LZ1PPL/Si4735/README.md

# Reciver based on Si4735 and Si5351
The Si5351 is used as a local oscilator to create IF frequency of 10.7MHz. 
The demodulation of the signals and filters is achived in the Si4735.
