LZ1PPL/Si4735/Hardware/si4735v2.3.1.pdf

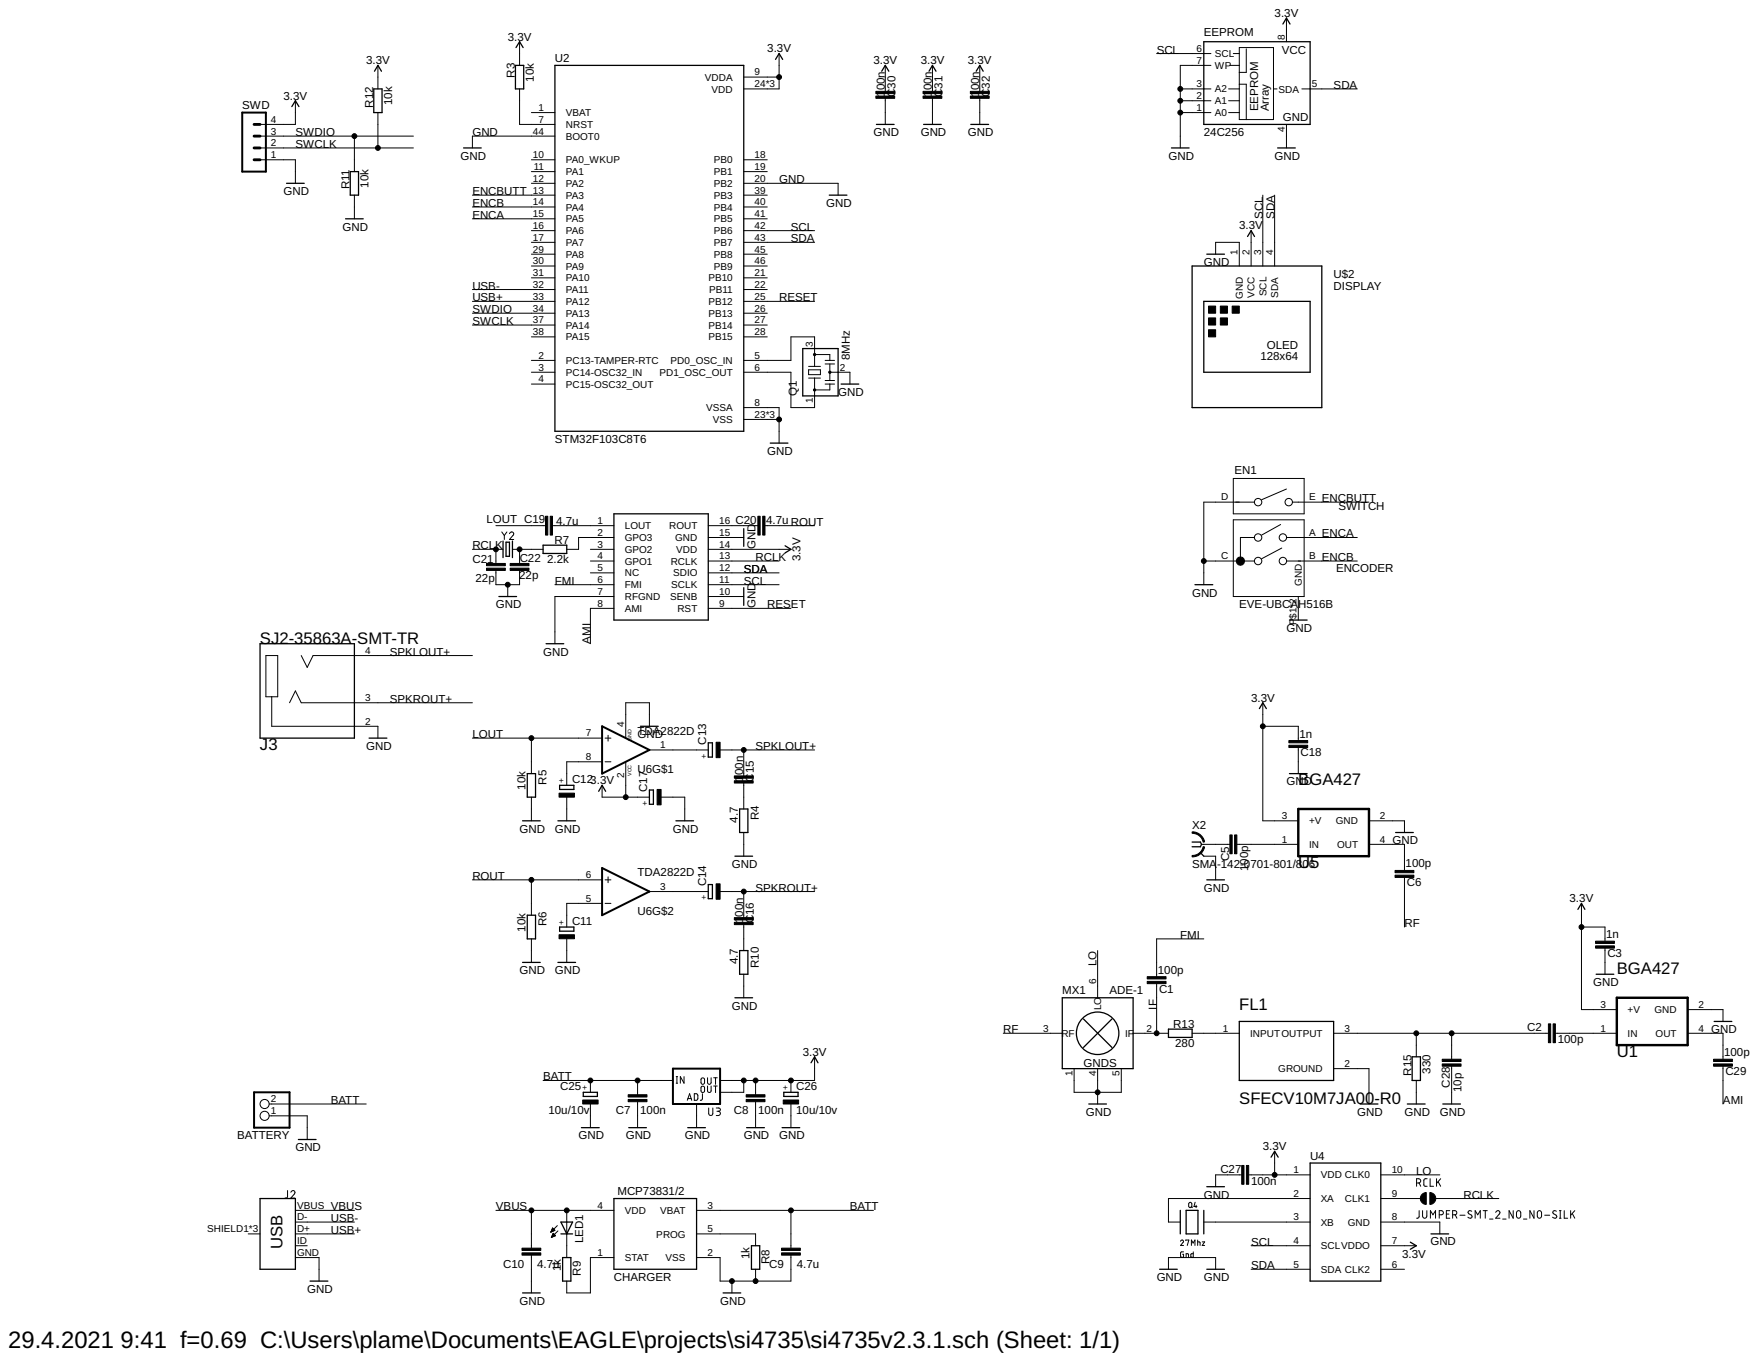
[picture p1: page 1]

29.4.2021 9:41 f=0.69 C:\Users\plame\Documents\EAGLE\projects\si4735\si4735v2.3.1.sch (Sheet: 1/1)
