LZ1PPL/Si4735/Hardware/si4735v2.3.1_b.pdf

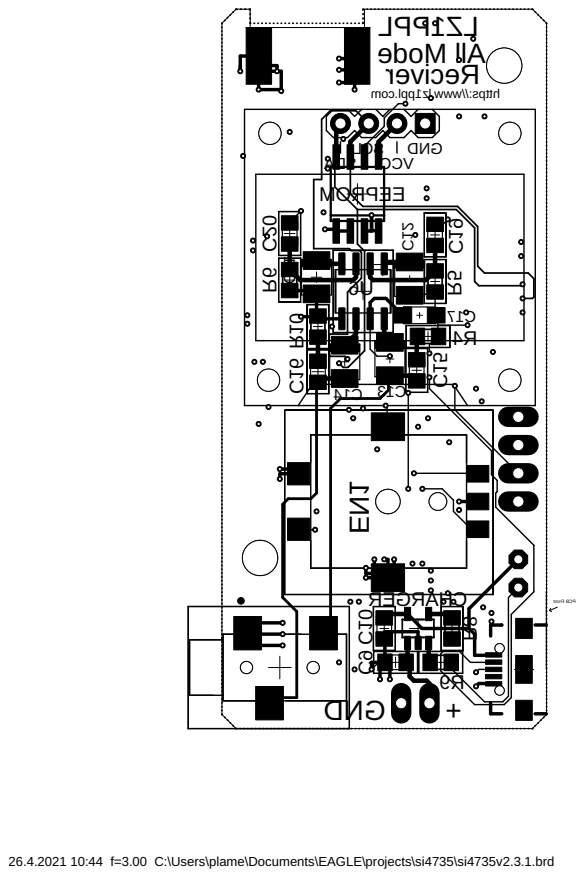
[picture p2: page 1]

26.4.2021 10:44 f=3.00 C:\Users\plame\Documents\EAGLE\projects\si4735\si4735v2.3.1.brd
