LZ1PPL/Si4735/Hardware/si4735v2.4.brd

## EAGLE design Hardware/si4735v2.4.brd (2021-06-22)

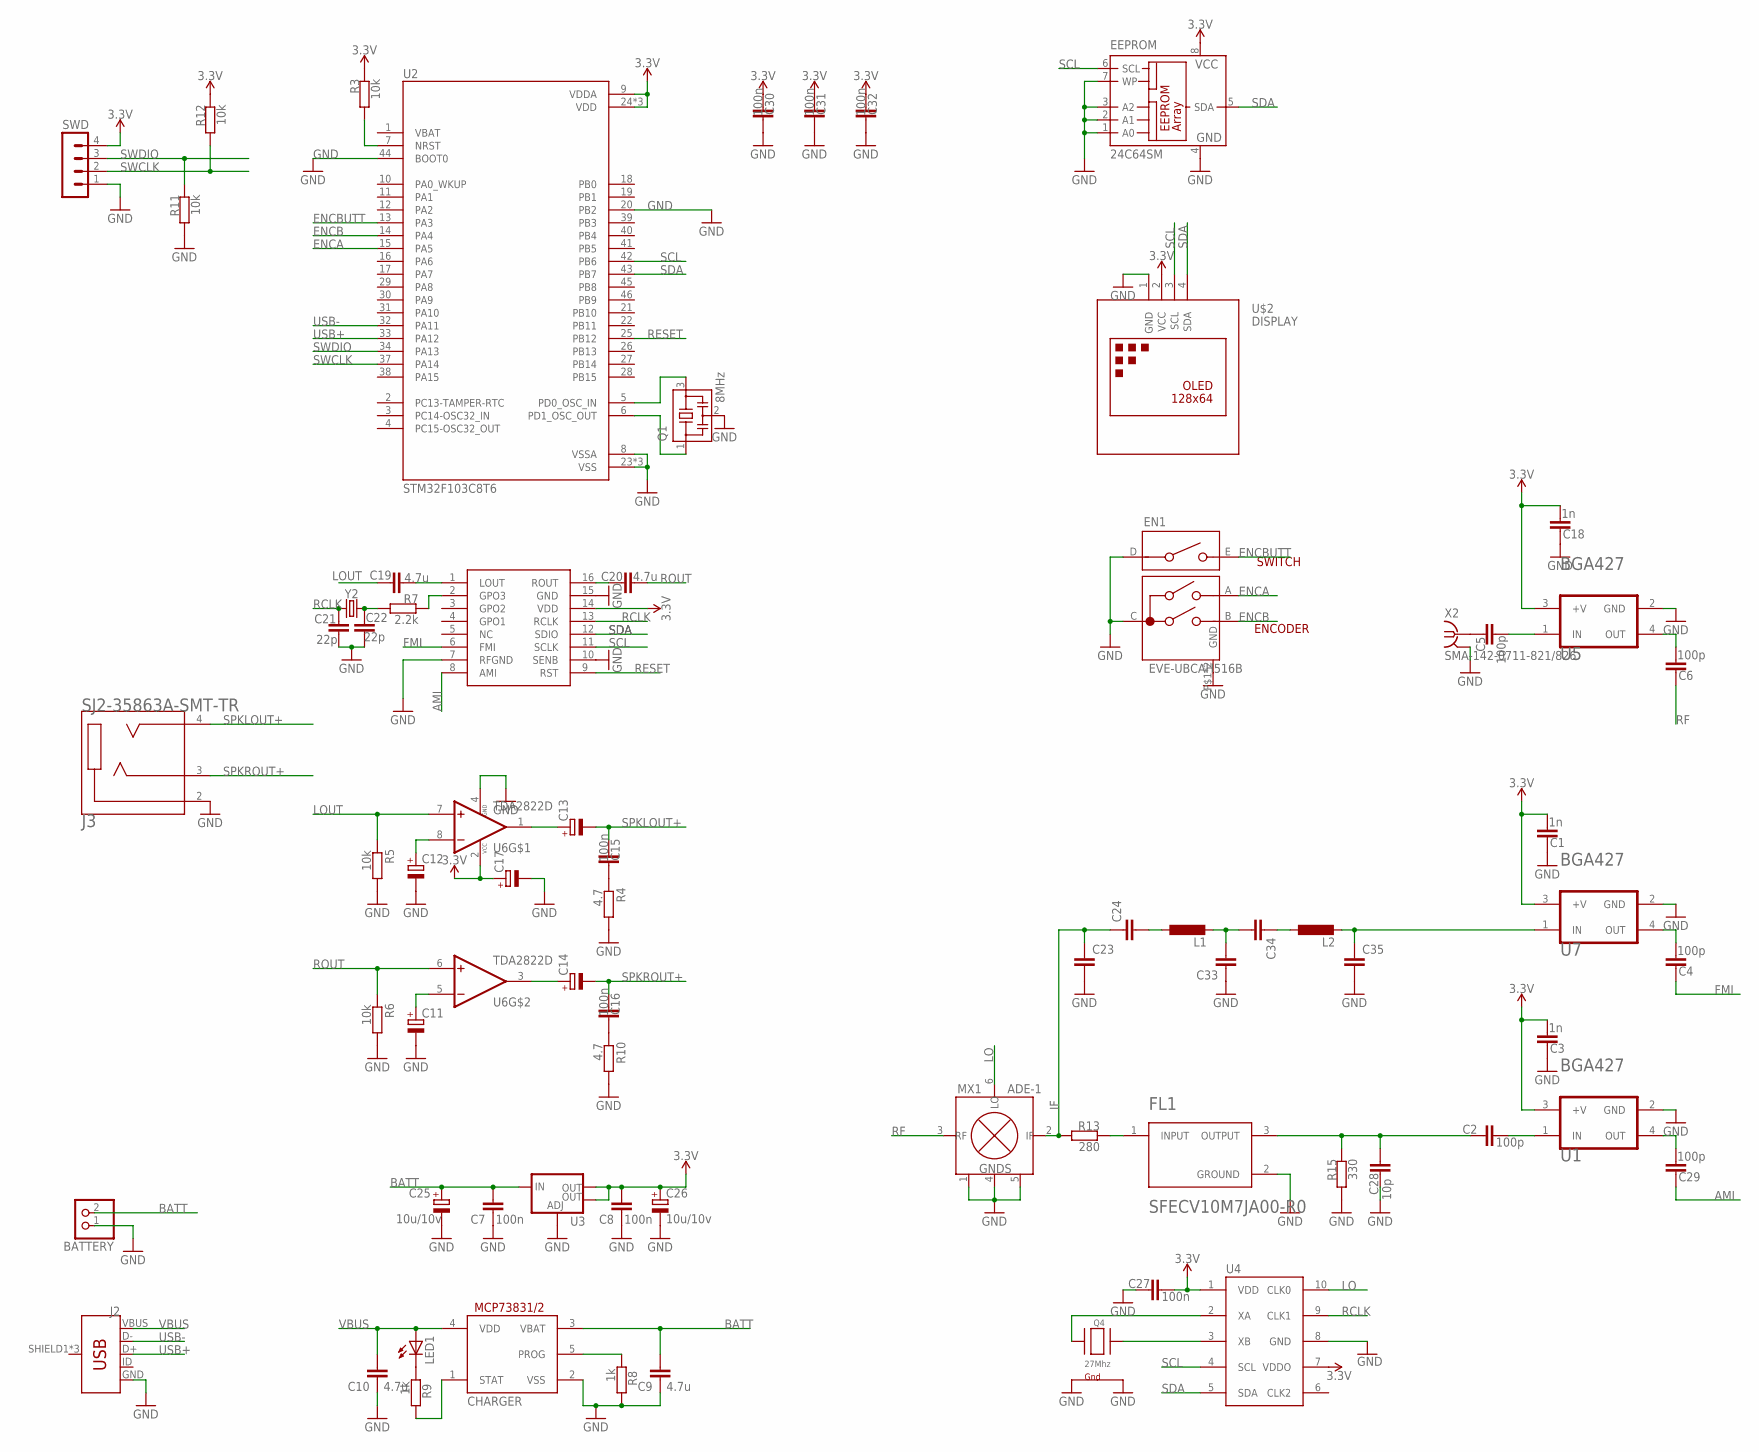
[picture p4: schematic si4735v2.4.sch]

Parts:
BATTERY: PINHD-1X2; 1X02
C1, C3, C18: 1n; C0805
C2, C4, C5, C6, C29: 100p; C0805
C7, C8, C15, C16, C27, C30, C31, C32: 100n; C0805
C9, C10, C19, C20: 4.7u; C0805
C11, C12, C13, C14: CPOL-EUSMCB; SMC_B
C17: CPOL-EUSMCA; SMC_A
C21, C22: 22p; C0805
C23, C24, C33, C34, C35: C-EUC0603; C0603
C25, C26: 10u/10v; A/3216-18W
C28: 10p; C0805
CHARGER: MCP73831/OT; SOT23-5L
EEPROM: 24C64SM; SO-08M
EN1: EVE-UBCAH516B
FL1: MURATA_ELECTRONICS_NORTH_AMERICA_SFECV10M7JA00-R0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; MURATA_ELECTRONICS_NORTH_AMERICA_SFECV10M7JA00-R0_0
J2: USB_MICRO-BREDUCED_PASTE; USB-B-MICRO-SMD_RED_PASTE
J3: SJ2-35863A-SMT-TR; CUI_SJ2-35863A-SMT-TR
L1, L2: L-EUL0603; L0603
LED1: LED3MM
MX1: ADE-1; CD636
Q1: 8MHz; CSTCR6M
Q4: 27Mhz; NX3225
R3, R5, R6, R11, R12: 10k; R0805
R4, R10: 4.7; R0805
R7: 2.2k; R0805
R8, R9: 1k; R0805
R13: 280; R0805
R15: 330; R0805
SI4732-A10: SI4732; SOIC127P600X175-16N
SWD: MA04-1
U1, U5, U7: INFINEON_BGA427INFINEON_BGA427_0_0; INFINEON_BGA427_0
U2: STM32F103C8T6; QFP50P900X900X160-48N
U3: V_REG_LM1117SOT223; SOT223
U4: SI5351A_CLOCK_GEN; MSOP-10
U6: TDA2822D; SOIC127P600X175-8N
U$2: DISPLAY; DISPLAY-OLED-128X64-I2C
X2: SMA-142-0711-821/826; J502-ND-142-0711-821/826
Y2: CRYSTALSMD-3.2X1.5; CRYSTAL-SMD-3.2X1.5MM

Connections:
3.3V: C1.1, C3.1, C8.2, C17.+, C18.1, C26.+, C27.1, C30.2, C31.2, C32.2, EEPROM.8 (VCC), R3.1, R12.1, SI4732-A10.14 (VDD), SWD.4, U1.3 (+V), U2.9 (VDDA), U2.24 (VDD), U2.36 (VDD), U2.48 (VDD), U3.2 (OUT), U3.4 (OUT), U4.1 (VDD), U4.7 (VDDO), U5.3 (+V), U6.2 (VCC), U7.3 (+V), U$2.2 (VCC)
AMI: C29.2, SI4732-A10.8 (AMI)
BATT: BATTERY.2, C7.2, C9.2, C25.+, CHARGER.3 (VBAT), U3.3 (IN)
ENCA: EN1.A, U2.15 (PA5)
ENCB: EN1.B, U2.14 (PA4)
ENCBUTT: EN1.E, U2.13 (PA3)
FILTER: C2.2, C28.1, FL1.3 (OUTPUT), R15.1
FMI: C4.2, SI4732-A10.6 (FMI)
GND: BATTERY.1, C1.2, C3.2, C7.1, C8.1, C9.1, C10.1, C11.-, C12.-, C17.-, C18.2, C21.1, C22.1, C23.2, C25.-, C26.-, C27.2, C28.2, C30.1, C31.1, C32.1, C33.1, C35.2, CHARGER.2 (VSS), EEPROM.1 (A0), EEPROM.2 (A1), EEPROM.3 (A2), EEPROM.4 (GND), EEPROM.7 (WP), EN1.C, EN1.D, EN1.P$1 (GND), EN1.P$2 (GND), FL1.2 (GROUND), J2.GND, J3.2 (SLEEVE), MX1.1 (GND), MX1.4 (GND), MX1.5 (GND), Q1.2, Q4.2 (G2), Q4.4 (G1), R4.2, R5.2, R6.2, R8.2, R10.2, R11.2, R15.2, SI4732-A10.7 (RFGND), SI4732-A10.10 (SENB), SI4732-A10.15 (GND), SWD.1, U1.2 (GND), U2.8 (VSSA), U2.20 (PB2), U2.23 (VSS), U2.35 (VSS), U2.44 (BOOT0), U2.47 (VSS), U3.1 (ADJ), U4.8 (GND), U5.2 (GND), U6.4 (GND), U7.2 (GND), U$2.1 (GND), X2.G@1 (2), X2.G@2 (2), X2.G@3 (2), X2.G@4 (2)
IF: C23.1, C24.1, MX1.2 (IF), R13.2
LO: MX1.6 (LO), U4.10 (CLK0)
LOUT: C19.2, R5.1, U6.7 (1IN+)
unnamed: Q1.3, U2.5 (PD0_OSC_IN)
unnamed: Q1.1, U2.6 (PD1_OSC_OUT)
unnamed: CHARGER.5 (PROG), R8.1
unnamed: C2.1, U1.1 (IN)
unnamed: C35.1, L2.2, U7.1 (IN)
unnamed: C6.1, U5.4 (OUT)
unnamed: C5.1, U5.1 (IN)
unnamed: C4.1, U7.4 (OUT)
unnamed: C12.+, U6.8 (1IN-)
unnamed: C11.+, U6.5 (2IN-)
unnamed: Q4.3 (X2), U4.3 (XB)
unnamed: C14.+, U6.3 (2OUT)
unnamed: Q4.1 (X1), U4.2 (XA)
unnamed: C13.+, U6.1 (1OUT)
unnamed: C15.1, R4.1
unnamed: C19.1, SI4732-A10.1 (LOUT)
unnamed: C20.1, SI4732-A10.16 (ROUT)
unnamed: C22.2, R7.2, Y2.P$2 (2)
unnamed: C16.1, R10.1
unnamed: R7.1, SI4732-A10.2 (GPO3)
unnamed: C5.2, X2.1
unnamed: C24.2, L1.1
unnamed: LED1.K (C), R9.1
unnamed: CHARGER.1 (STAT), R9.2
unnamed: C29.1, U1.4 (OUT)
unnamed: C33.2, C34.2, L1.2
unnamed: FL1.1 (INPUT), R13.1
unnamed: R3.2, U2.7 (NRST)
unnamed: C34.1, L2.1
RCLK: C21.2, SI4732-A10.13 (RCLK), U4.9 (CLK1), Y2.P$1 (1)
RESET: SI4732-A10.9 (RST), U2.25 (PB12)
RF: C6.2, MX1.3 (RF)
ROUT: C20.2, R6.1, U6.6 (2IN+)
SCL: EEPROM.6 (SCL), SI4732-A10.11 (SCLK), U2.42 (PB6), U4.4 (SCL), U$2.3 (SCL)
SDA: EEPROM.5 (SDA), SI4732-A10.12 (SDIO), U2.43 (PB7), U4.5 (SDA), U$2.4 (SDA)
SPKLOUT+: C13.-, C15.2, J3.4 (TIP)
SPKROUT+: C14.-, C16.2, J3.3 (RING)
SWCLK: R12.2, SWD.2, U2.37 (PA14)
SWDIO: R11.1, SWD.3, U2.34 (PA13)
USB+: J2.D+, U2.33 (PA12)
USB-: J2.D-, U2.32 (PA11)
VBUS: C10.2, CHARGER.4 (VDD), J2.VBUS, LED1.A

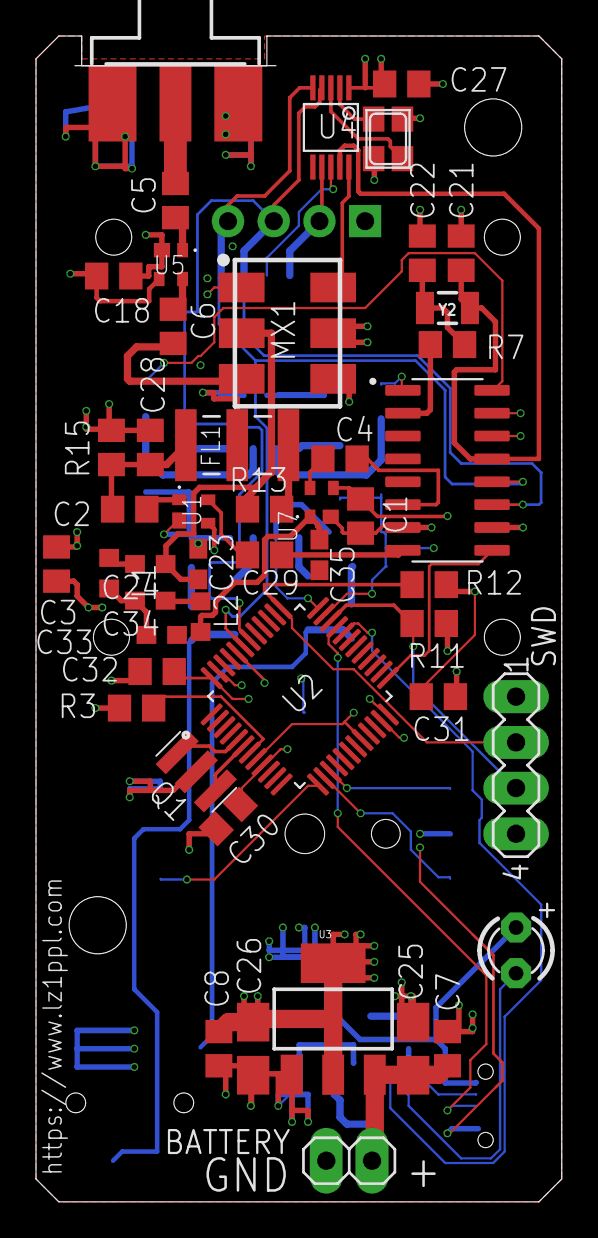
[picture p5: board si4735v2.4.brd from above]

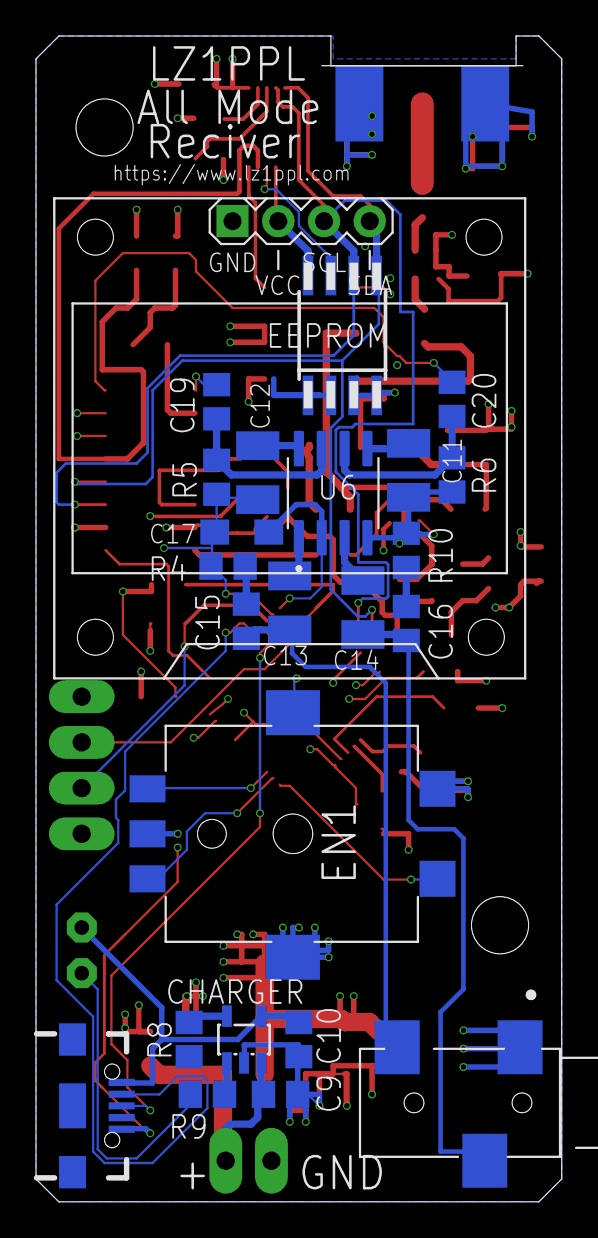
[picture p6: board si4735v2.4.brd from below]

Board: 4 copper layers, 29.2 x 64.8 mm, 72 parts (24 on the bottom side), 54 nets.
