LZ1PPL/Si4735/Si4735-Si5351_STM32_FM.ino

#include <Rotary.h>
#include <SI4735.h>
#include <si5351.h>
#include <EEPROM.h>
#include <Adafruit_GFX.h>
#include <Adafruit_SSD1306.h>
#include "patch_ssb_compressed.h"       // SSB patch for whole SSBRX initialization string
#define I2C_ADDRESS   0x3C    // OLED I2C address
#define SCREEN_WIDTH  128     // OLED display width, in pixels
#define SCREEN_HEIGHT  64     // OLED display height, in pixels
#define OLED_RESET    4       // Reset pin # (or -1 if sharing Arduino reset pin)
#define MIN_ELAPSED_TIME  150
#define ELAPSED_COMMAND  3000
#define IF_FM  65700          //72300 //Enter your IF frequency, from: 64000 to 108000, 0 = to direct convert receiver or RF generator, + will add and - will subtract IF offfset.
#define IF  10700             //Enter your IF frequency, ex: 455 = 455kHz, 10700 = 10.7MHz, 0 = to direct convert receiver or RF generator, + will add and - will subtract IF offfset.
#define FREQ_INIT  9300000    //Enter your initial frequency at startup, ex: 7000000 = 7MHz, 10000000 = 10MHz, 840000 = 840kHz.
#define XT_CAL_F  39000       //Si5351 calibration factor, adjust to get exatcly 10MHz. 
#define XTAL_F  27000000      //Xtal frequency for Si5351
#define EEPROM_I2C_ADDR  0x50 // You might need to change this value
#define button PA3
#define RESET_PIN PB12

Adafruit_SSD1306 display(SCREEN_WIDTH, SCREEN_HEIGHT, &Wire, OLED_RESET);
Rotary r = Rotary(PA4, PA5);
SI4735 si4735;
Si5351 si5351(0x62);

const uint16_t size_content = sizeof ssb_patch_content;

int encoder0Pos = 0;
int valF;
byte MenueEnable = 0;
byte menuCount = 1;
byte dir = 0;
byte ssbload = 0;
bool runState = false;
//unsigned long fstep;
const char *currentMode;
const char *BandWidth;
const char *agcNdx;
int volume = 45;
int currentBFO = 0;
int ATT;
bool agc = 0;
long elapsedCommand = millis();
uint8_t countClick = 0;
unsigned long freq = FREQ_INIT;
unsigned long freqold, fstep;
unsigned long firstv, secondv;
long interfreq = IF;
long interfreq_FM = IF_FM;
long cal = XT_CAL_F;
byte encoder = 1;
byte stp;
unsigned int period = 100;   //millis display active
unsigned long time_now = 0;  //millis display active
String steps;

void setup() {
  pinMode(PA4, INPUT_PULLUP);
  pinMode(PA5, INPUT_PULLUP);
  pinMode(PA3, INPUT_PULLUP);
  encoder0Pos = EEPROM.read(menuCount);
  display.begin(SSD1306_SWITCHCAPVCC, 0x3C);
  display.setTextColor(SSD1306_WHITE);
  display.clearDisplay();
  display.setTextSize(2);
  display.setCursor(32, 0);
  display.print("LZ1PPL");
  display.display();
  delay(200);
  display.setCursor(44, 20);
  display.setTextSize(1);
  display.print("All Mode");
  display.setCursor(47, 32);
  display.print("Reciver");
  display.setCursor(29, 45);
  display.print("Si4735-Si5351");
  display.display();
  delay(500);

  si5351.init(SI5351_CRYSTAL_LOAD_10PF, 27000000, XT_CAL_F);
  si5351.output_enable(SI5351_CLK0, 1);                  //1 - Enable / 0 - Disable CLK
  si5351.drive_strength(SI5351_CLK0, SI5351_DRIVE_4MA);  //Output current 2MA, 4MA, 6MA or 8MA
  si4735.setup(RESET_PIN, 1);

  si4735.setI2CFastMode(); // Set I2C bus speed.
  si4735.getDeviceI2CAddress(RESET_PIN); // Looks for the I2C bus address and set it.  Returns 0 if error
  si4735.setup(RESET_PIN, -1, 1, SI473X_ANALOG_AUDIO);

  delay(300);
  EEPROM.get(10, freq);
  int fst = EEPROM.read(1);
  if (fst == 1)
  {
    fstep = 1;
    steps = "1Hz";
  }
  if (fst == 2)
  {
    fstep = 10;
    steps = "10Hz";
  }    if (fst == 3)
  {
    fstep = 100;
    steps = "100Hz";
  }    if (fst == 4)
  {
    fstep = 1000;
    steps = "1kHz";
  }
  if (fst == 5)
  {
    fstep = 5000;
    steps = "5kHz";
  }
  if (fst == 6)
  {
    fstep = 10000;
    steps = "10kHz";
  }
  if (fst == 7)
  {
    fstep = 100000;
    steps = "100kHz";
  }
  if (fst == 8)
  {
    fstep = 1000000;
    steps = "1MHz";
  }
  int Mo = EEPROM.read(2);
  if (Mo == 1)
  {
    currentMode = "FM";
    //si4735.reset();
    si4735.setTuneFrequencyAntennaCapacitor(0);
    si4735.setFM(6500, 6600, IF_FM / 10, 1);
    ssbload = 0;
  }
  if (Mo == 2)
  {
    currentMode = "AM";
    //si4735.reset();
    si4735.setTuneFrequencyAntennaCapacitor(1);
    si4735.setAM(10650, 10750, IF, 1);
    ssbload = 0;
  }
  if (Mo == 3)
  {
    currentMode = "LSB";
    /*
      if (ssbload == 0)
      {
      loadSSB();
      ssbload = 1;
      }
    */
    si4735.reset();
    si4735.setTuneFrequencyAntennaCapacitor(1);
    si4735.loadPatch(ssb_patch_content, size_content, 1);
    si4735.setSSB(10650, 10750, IF, 1, 2);
    si4735.setSSBAutomaticVolumeControl(1);
  }
  if (Mo == 4)
  {
    currentMode = "USB";
    /*
      if (ssbload == 0)
      {
      loadSSB();
      ssbload = 1;
      }
    */
    si4735.reset();
    si4735.setTuneFrequencyAntennaCapacitor(1);
    si4735.loadPatch(ssb_patch_content, size_content, 2);
    si4735.setSSB(10650, 10750, IF, 1, 1);
    si4735.setSSBAutomaticVolumeControl(1);
  }
  int Filter = EEPROM.read(3);
  if (Filter == 1)
  {
    if (currentMode == "AM")
    {
      si4735.setBandwidth(4, 1);
      BandWidth = "1kHz";
      delay(200);
    }
    if (currentMode == "LSB" || currentMode == "USB")
    {
      si4735.setBandwidth(4, 1);
      si4735.setSSBAudioBandwidth(4);
      si4735.setSBBSidebandCutoffFilter(0);
      BandWidth = "0.5kHz";
    }
    if (currentMode == "FM")
    {
      si4735.setFmBandwidth(0);
      BandWidth = "Auto";
      delay (200);
    }
  }
  if (Filter == 2)
  {
    if (currentMode == "AM")
    {
      si4735.setBandwidth(3, 1);
      BandWidth = "2kHz";
      delay(200);
    }
    if (currentMode == "LSB" || currentMode == "USB")
    {
      si4735.setBandwidth(4, 1);
      si4735.setSSBAudioBandwidth(5);
      si4735.setSBBSidebandCutoffFilter(0);
      BandWidth = "1kHz";
    }
    if (currentMode == "FM")
    {
      si4735.setFmBandwidth(1);
      BandWidth = "110kHz";
      delay (200);
    }
  }
  if (Filter == 3)
  {
    if (currentMode == "AM")
    {
      si4735.setBandwidth(6, 1);
      BandWidth = "2.5kHz";
      delay(200);
    }
    if (currentMode == "LSB" || currentMode == "USB")
    {
      si4735.setBandwidth(3, 1);
      si4735.setSSBAudioBandwidth(0);
      si4735.setSBBSidebandCutoffFilter(0);
      BandWidth = "1.2kHz";
    }
    if (currentMode == "FM")
    {
      si4735.setFmBandwidth(2);
      BandWidth = "84kHz";
      delay (200);
    }
  }
  if (Filter == 4)
  {
    if (currentMode == "AM")
    {
      si4735.setBandwidth(2, 1);
      BandWidth = "3kHz";
      delay(200);
    }
    if (currentMode == "LSB" || currentMode == "USB")
    {
      si4735.setBandwidth(6, 1);
      si4735.setSSBAudioBandwidth(1);
      si4735.setSBBSidebandCutoffFilter(1);
      BandWidth = "2.2kHz";
    }
    if (currentMode == "FM")
    {
      si4735.setFmBandwidth(3);
      BandWidth = "60kHz";
      delay (200);
    }
  }
  if (Filter == 5)
  {
    if (currentMode == "AM")
    {
      si4735.setBandwidth(1, 1);
      BandWidth = "4kHz";
      delay(200);
    }
    if (currentMode == "LSB" || currentMode == "USB")
    {
      si4735.setBandwidth(2, 1);
      si4735.setSSBAudioBandwidth(2);
      si4735.setSBBSidebandCutoffFilter(1);
      BandWidth = "3kHz";
    }
    if (currentMode == "FM")
    {
      si4735.setFmBandwidth(4);
      BandWidth = "40kHz";
      delay (200);
    }
  }
  if (Filter == 6)
  {
    if (currentMode == "AM")
    {
      si4735.setBandwidth(0, 1);
      BandWidth = "6kHz";
      delay(200);
    }
    if (currentMode == "LSB" || currentMode == "USB")
    {
      si4735.setBandwidth(1, 1);
      si4735.setSSBAudioBandwidth(3);
      si4735.setSBBSidebandCutoffFilter(1);
      BandWidth = "4kHz";
    }
  }
  si4735.setVolume (EEPROM.read(4));
  int agc_ee = EEPROM.read(5);
  if (agc_ee == 1)
  {
    si4735.setAutomaticGainControl(0, 0);
    agc = 1;
    delay(200);
  }
  if (agc_ee == 2)
  {
    si4735.setAutomaticGainControl(1, 0);
    agc = 0;
    delay(200);
  }
  int bfo_ee = EEPROM.read(6);
  currentBFO = map(bfo_ee, 0, 255, -127, 127);
  currentBFO = currentBFO * 10;
  si4735.setSSBBfo(currentBFO);

  //si4735.setRefClock(32768);
  attachInterrupt(digitalPinToInterrupt(PA4), rot, CHANGE);
  attachInterrupt(digitalPinToInterrupt(PA5), rot, CHANGE);
  attachInterrupt(digitalPinToInterrupt(PA3), butt, FALLING);
}

void rot() {
  char result = r.process();
  if (result == DIR_CW)
  {
    dir = -1;
    set_frequency(-1);
    //f=f+1
    encoder0Pos = encoder0Pos - 1;
    encoder0Pos = constrain(encoder0Pos, 0, 255);
    elapsedCommand = millis();
  }
  else if (result == DIR_CCW)
  {
    dir = 1;
    set_frequency(1);
    //f=f-1
    encoder0Pos = encoder0Pos + 1;
    encoder0Pos = constrain(encoder0Pos, 0, 255);
    elapsedCommand = millis();
  }
}

void butt()
{
  countClick++;
  delay (MIN_ELAPSED_TIME);
  elapsedCommand = millis();
  //firstv = millis();
  attachInterrupt(digitalPinToInterrupt(PA3), up, RISING);
}

void up()
{
  secondv = millis();
  if ((secondv - elapsedCommand) >= 4000) {
    firstv = secondv;
    EEPROM.put(10, freq);
  }
  attachInterrupt(digitalPinToInterrupt(PA3), butt, FALLING);
}

void loadSSB()
{
  si4735.setI2CFastMode(); // Recommended
  si4735_eeprom_patch_header eep;
  //si4735.reset();
  si4735.queryLibraryId(); // Is it really necessary here? I will check it.
  si4735.patchPowerUp();
  delay(50);
  eep = si4735.downloadPatchFromEeprom(EEPROM_I2C_ADDR);
  si4735.setI2CStandardMode(); // goes back to default (100kHz)
  // Parameters
  // AUDIOBW - SSB Audio bandwidth; 0 = 1.2kHz (default); 1=2.2kHz; 2=3kHz; 3=4kHz; 4=500Hz; 5=1kHz;
  // SBCUTFLT SSB - side band cutoff filter for band passand low pass filter ( 0 or 1)
  // AVC_DIVIDER  - set 0 for SSB mode; set 3 for SYNC mode.
  // AVCEN - SSB Automatic Volume Control (AVC) enable; 0=disable; 1=enable (default).
  // SMUTESEL - SSB Soft-mute Based on RSSI or SNR (0 or 1).
  // DSP_AFCDIS - DSP AFC Disable or enable; 0=SYNC MODE, AFC enable; 1=SSB MODE, AFC disable.
  si4735.setSSBConfig(1, 0, 0, 1, 0, 1);
  delay(25);
}

void set_frequency(short dir) {
  //Up/Down frequency
  if (MenueEnable == 0)
  {
    if (dir == 1) freq = freq + fstep;
    if (freq >= 230000000) freq = 230000000;
    if (dir == -1) freq = freq - fstep;
    if (fstep == 1000000 && freq <= 1000000) freq = 1000000;
    else if (freq <= 100000) freq = 100000;
  }
}

void tunegen() {
  if (MenueEnable == 0)
  {
    if (currentMode == "FM")
    {
      if (freq >= 170000000)
      {
        si5351.set_freq((freq - (interfreq_FM * 1000ULL)) * 100ULL, SI5351_CLK0);
      }
      if (freq < 170000000)
      {
        si5351.set_freq((freq + (interfreq_FM * 1000ULL)) * 100ULL, SI5351_CLK0);
      }
    }
    else
    {
      si5351.set_freq((freq + (interfreq * 1000ULL)) * 100ULL, SI5351_CLK0);
    }
  }
}

void staticMenu() {
  display.setTextSize(1);
  display.clearDisplay();
  display.setCursor(10, 0);
  display.print("Step:");
  display.setCursor(80, 0);
  display.print(steps);

  display.setCursor(10, 10);
  display.print("Mode:");
  display.setCursor(80, 10);
  display.print(currentMode);

  display.setCursor(10, 20);
  display.print("BandWidth:");
  display.setCursor(80, 20);
  display.print(BandWidth);

  display.setCursor(10, 30);
  display.print("Volume:");
  display.setCursor(80, 30);
  display.print(volume);

  display.setCursor(10, 40);
  display.print("AGC/ATT:");
  display.setCursor(80, 40);
  if (agc == 1) {
    display.print("AGC ON");
  }
  else {
    display.print("AGC OFF");
  }
  display.setCursor(10, 50);
  display.print("BFO:");
  display.setCursor(80, 50);
  display.print(currentBFO);
  display.setCursor(2, ((menuCount) - 1) * 10);
  display.print(">");

  if ((millis() - elapsedCommand) > ELAPSED_COMMAND)
  {
    countClick = 0;
    MenueEnable = 0;
  }
  menuCheck();
  display.display();
}

void menuCheck() {
  if (digitalRead(button) == LOW && menuCount < 6) {
    delay(MIN_ELAPSED_TIME);
    menuCount++;
    elapsedCommand = millis();
    EEPROM.write(menuCount - 1, encoder0Pos);
    encoder0Pos = EEPROM.read(menuCount);
    display.setCursor(2, (menuCount) - 1);
    display.print(" ");
  }
  if (digitalRead(button) == LOW && menuCount >= 6) {
    delay(MIN_ELAPSED_TIME);
    menuCount = 1;
    elapsedCommand = millis();
    EEPROM.write(6, encoder0Pos);
    encoder0Pos = EEPROM.read(menuCount);
    display.setCursor(2, 60);
    display.print(" ");
  }
  if (menuCount == 1) {        // Steps
    if (encoder0Pos == 1)
    {
      fstep = 1;
      steps = "1Hz";
    }
    if (encoder0Pos == 2)
    {
      fstep = 10;
      steps = "10Hz";
    }    if (encoder0Pos == 3)
    {
      fstep = 100;
      steps = "100Hz";
    }    if (encoder0Pos == 4)
    {
      fstep = 1000;
      steps = "1kHz";
    }
    if (encoder0Pos == 5)
    {
      fstep = 5000;
      steps = "5kHz";
    }
    if (encoder0Pos == 6)
    {
      fstep = 10000;
      steps = "10kHz";
    }
    if (encoder0Pos == 7)
    {
      fstep = 100000;
      steps = "100kHz";
    }
    if (encoder0Pos == 8)
    {
      fstep = 1000000;
      steps = "1MHz";
    }
    if (encoder0Pos < 1)
    {
      encoder0Pos = 8;
    }
    if (encoder0Pos > 8)
    {
      encoder0Pos = 1;
    }
  }
  if (menuCount == 2) {       // Set Mode
    if (encoder0Pos == 1)
    {
      if (currentMode != "FM")
      {
        currentMode = "FM";
        //si4735.reset();
        si4735.setTuneFrequencyAntennaCapacitor(0);
        si4735.setFM(6500, 6600, IF_FM / 10, 1);
        ssbload = 0;
      }
    }
    if (encoder0Pos == 2)
    {
      if (currentMode != "AM")
      {
        currentMode = "AM";
        //si4735.reset();
        si4735.setTuneFrequencyAntennaCapacitor(1);
        si4735.setAM(10650, 10750, IF, 1);
        ssbload = 0;
      }
    }
    if (encoder0Pos == 3)
    {
      if (currentMode != "LSB")
      {
        currentMode = "LSB";
        /*
          if (ssbload == 0)
          {
          loadSSB();
          ssbload = 1;
          }
        */
        si4735.reset();
        si4735.setTuneFrequencyAntennaCapacitor(1);
        si4735.loadPatch(ssb_patch_content, size_content, 1);
        si4735.setSSB(10650, 10750, IF, 1, 2);
        si4735.setSSBAutomaticVolumeControl(1);
      }
    }
    if (encoder0Pos == 4)
    {
      if (currentMode != "USB")
      {
        currentMode = "USB";
        /*
          if (ssbload == 0)
          {
          loadSSB();
          ssbload = 1;
          }
        */
        si4735.reset();
        si4735.setTuneFrequencyAntennaCapacitor(1);
        si4735.loadPatch(ssb_patch_content, size_content, 2);
        si4735.setSSB(10650, 10750, IF, 1, 1);
        si4735.setSSBAutomaticVolumeControl(1);
      }
    }
    if (encoder0Pos < 1)
    {
      encoder0Pos = 4;
    }
    if (encoder0Pos > 4)
    {
      encoder0Pos = 1;
    }
  }
  if (menuCount == 3) {            // Set Bandwidth
    if (encoder0Pos == 1)
    {
      if (currentMode == "AM")
      {
        if (BandWidth != "1kHz")
        {
          si4735.setBandwidth(4, 1);
          BandWidth = "1kHz";
          delay (200);
        }
      }
      if (currentMode == "LSB" || currentMode == "USB")
      {
        if (BandWidth != "0.5kHz")
        {
          si4735.setBandwidth(4, 1);
          si4735.setSSBAudioBandwidth(4);
          si4735.setSBBSidebandCutoffFilter(0);
          BandWidth = "0.5kHz";
          delay (200);
        }
      }
      if (currentMode == "FM")
      {
        if (BandWidth != "Auto")
        {
          si4735.setFmBandwidth(0);
          BandWidth = "Auto";
          delay (200);
        }
      }
    }
    if (encoder0Pos == 2)
    {
      if (currentMode == "AM")
      {
        if (BandWidth != "2kHz")
        {
          si4735.setBandwidth(3, 1);
          BandWidth = "2kHz";
          delay (200);
        }
      }
      if (currentMode == "LSB" || currentMode == "USB")
      {
        if (BandWidth != "1kHz")
        {
          si4735.setBandwidth(4, 1);
          si4735.setSSBAudioBandwidth(5);
          si4735.setSBBSidebandCutoffFilter(0);
          BandWidth = "1kHz";
          delay (200);
        }
      }
      if (currentMode == "FM")
      {
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
      currentBFO = currentBFO * 10;
      si4735.setSSBBfo(currentBFO);
    }
  }
}

void displayfreq() {
  unsigned int m = freq / 1000000;
  unsigned int k = (freq % 1000000) / 1000;
  unsigned int h = (freq % 1000) / 1;
  display.setTextSize(2);
  display.clearDisplay();

  char buffer[15] = "";
  if (m < 1) {
    display.setCursor(0, 2); sprintf(buffer, "%003d.%003d", k, h);
  }
  else if (m < 100) {
    display.setCursor(0, 2); sprintf(buffer, "%2d.%003d.%003d", m, k, h);
  }
  else if (m >= 100) {
    unsigned int h = (freq % 1000) / 10;
    display.setCursor(0, 2); sprintf(buffer, "%2d.%003d.%02d", m, k, h);
  }
  display.print(buffer);
  display.drawFastHLine(0, 0, 128, SSD1306_WHITE);
  display.drawFastHLine(0, 17, 128, SSD1306_WHITE);
  display.drawFastVLine(127, 0, 17, SSD1306_WHITE);
  display.drawFastVLine(0, 0, 17, SSD1306_WHITE);
}

void displayset()
{
  display.setTextSize(1);
  display.setCursor(2, 21);
  display.print("BFO:");
  display.print(currentBFO);
  display.print("Hz");
  display.setCursor(78, 21);
  display.print("Mode:");
  display.print(currentMode);
  display.drawFastHLine(0, 30, 128, SSD1306_WHITE);
  display.drawFastVLine(67, 17, 13, SSD1306_WHITE);
  display.drawFastVLine(0, 17, 13, SSD1306_WHITE);
  display.drawFastVLine(127, 17, 13, SSD1306_WHITE);
  display.setCursor(2, 35);
  display.print("Step:");
  display.print(steps);
  display.setCursor(78, 35);
  display.print("Vol:");
  display.print(si4735.getVolume());
  display.setCursor(2, 46);
  display.print("BW:");
  display.print(BandWidth);
  display.setCursor(78, 46);
  if (agc == 1) {
    display.print("AGC ON");
  }
  else {
    display.print("AGC OFF");
  }

  ////////////////////////////////////////////////////////////////////////////////////
  // Bargraph as S Meter.                                                          //
  //Comment this and uncoment below to show on dispaly SNR/RSSI                    //
  ///////////////////////////////////////////////////////////////////////////////////
  int rssiAux = 0;
  si4735.getCurrentReceivedSignalQuality();
  int rssi = si4735.getCurrentRSSI();
  int val =  map(rssi, 0, 60, 0, 99);
  val = constrain(val, 0, 99);
  if (rssi == 0)
    rssiAux = 1;
  else if (rssi < 1)
    rssiAux = 2;
  else if (rssi < 2)
    rssiAux = 3;
  else if (rssi < 3)
    rssiAux = 4;
  else if (rssi < 6)
    rssiAux = 5;
  else if (rssi < 12)
    rssiAux = 6;
  else if (rssi < 25)
    rssiAux = 7;
  else if (rssi < 50)
    rssiAux = 8;
  else
    rssiAux = 9;
  display.drawRect(2, 57, 99, 7, 1); //Border of the bar chart
  display.fillRect(2, 57, val, 7, WHITE); //Draws the bar depending on the sensor value
  display.setCursor(105, 57);
  display.print("S");
  display.print(rssiAux);
  if (rssi > 60)
  {
    display.print("+");
  }

  /*
    display.setCursor(2, 57);
    si4735.getCurrentReceivedSignalQuality();
    display.print("SNR/RSSI:");
    display.print(si4735.getCurrentSNR());
    display.print("/");
    display.print(si4735.getCurrentRSSI());
  */

  display.display();
}

void loop() {
  if (countClick >= 2)
  {
    MenueEnable = 1;
  }
  if (MenueEnable == 1)
  {
    staticMenu();
  }

  if (MenueEnable == 0)
  {
    if (freqold != freq) {
      tunegen();
      freqold = freq;
    }
    displayfreq();
    displayset();
  }
  if (MenueEnable == 0)
  {
    if ((millis() - elapsedCommand) >= 1000)
    {
      countClick = 0;
    }
  }
  delay(10);
}
