LZ1PPL/Si4735/(commit log)

2021-04-27 Add files via upload
    Added Bandwidth filter for the FM mode
2021-06-22 Added BPF to the FMI input.
    PCB not tested yet.
    [si4735v2.4.brd, si4735v2.4.sch]
